derekcom17/caravel_user_project_ddr3_sstl/(commit log)

2022-02-15 Add more to SSTL test cell
    * TODO: seperate digital and I/O logic to use two seprate
    power supplies
2022-02-15 Integrate updated SSTL into test circuit
2022-02-20 Update SSTL test circuit
    * Add lvs extraction script
2022-02-27 Add top level user_project_wrapper cell
    * Add SSTL test circuit and wire up most signals
2022-03-01 Add schematic and spice TB for proj_sstl_test cell
    [SSTL.sch, analog_wrapper_tb.sch, example_por.sch, example_por_tb.sch, n-leg.sch, n-leg_tb.sch, p-leg.sch, p-leg_tb.sch]
2022-03-02 Edits and fixes to shift register layout
    * Add shift register schematic
    * LVS complete for shift register
    * Edits to project top level:
    * power clamps connected
    * alternate data sources connected to pwr and gnd
    [cfg_shift_register.sch]
2022-03-02 Add config sreg testbench
    * Some minor fixes
    [cfg_shift_register.sch, cfg_shift_register_tb.sch]
2022-03-05 Update to project simulation to add la data in
2022-03-06 Add series resistor to data input
    * Some basic esd protection
    * Fix drc issue from previous commit
    [proj_sstl_test.sch]
2022-03-09 Update wiring around pins
    * This is an attempt to fix the "Klayout Pin Label Purposes Overlapping Drawing" drc errors on precheck.
2022-03-09 Fix additional pin issue
    * Add metal back to pin
2022-03-10 Update SSTL to avoid FEOL DRC violations
    [proj_sstl_test.sch]
2022-03-10 Move LA pin to input instead of output
    * Move away the old verilog files
2022-03-10 Start on PRBS generation module schematic
    [prb_gen_tb.sch, prbs_gen.sch]
2022-03-11 Finish PRBS gen module schematic
    * Start on PRBS gen layout
    [prb_gen_tb.sch, prbs_gen.sch]
2022-03-11 Finish PRBS generator layout, add to top level
    * LVS passed against schematic
    * Clock control pins connected to gpio 9 to 11
    [prbs_gen.sch]
2022-03-12 Add reset to PRBS
    * Add to top level
    [prb_gen_tb.sch, prbs_gen.sch]
