derekcom17/caravel_user_project_ddr3_sstl/(notices)

Notices in the files:
README.md:
License: Apache 2.0
